RyanMeulenkamp/uselessbox/schematics/uselessbox.pdf

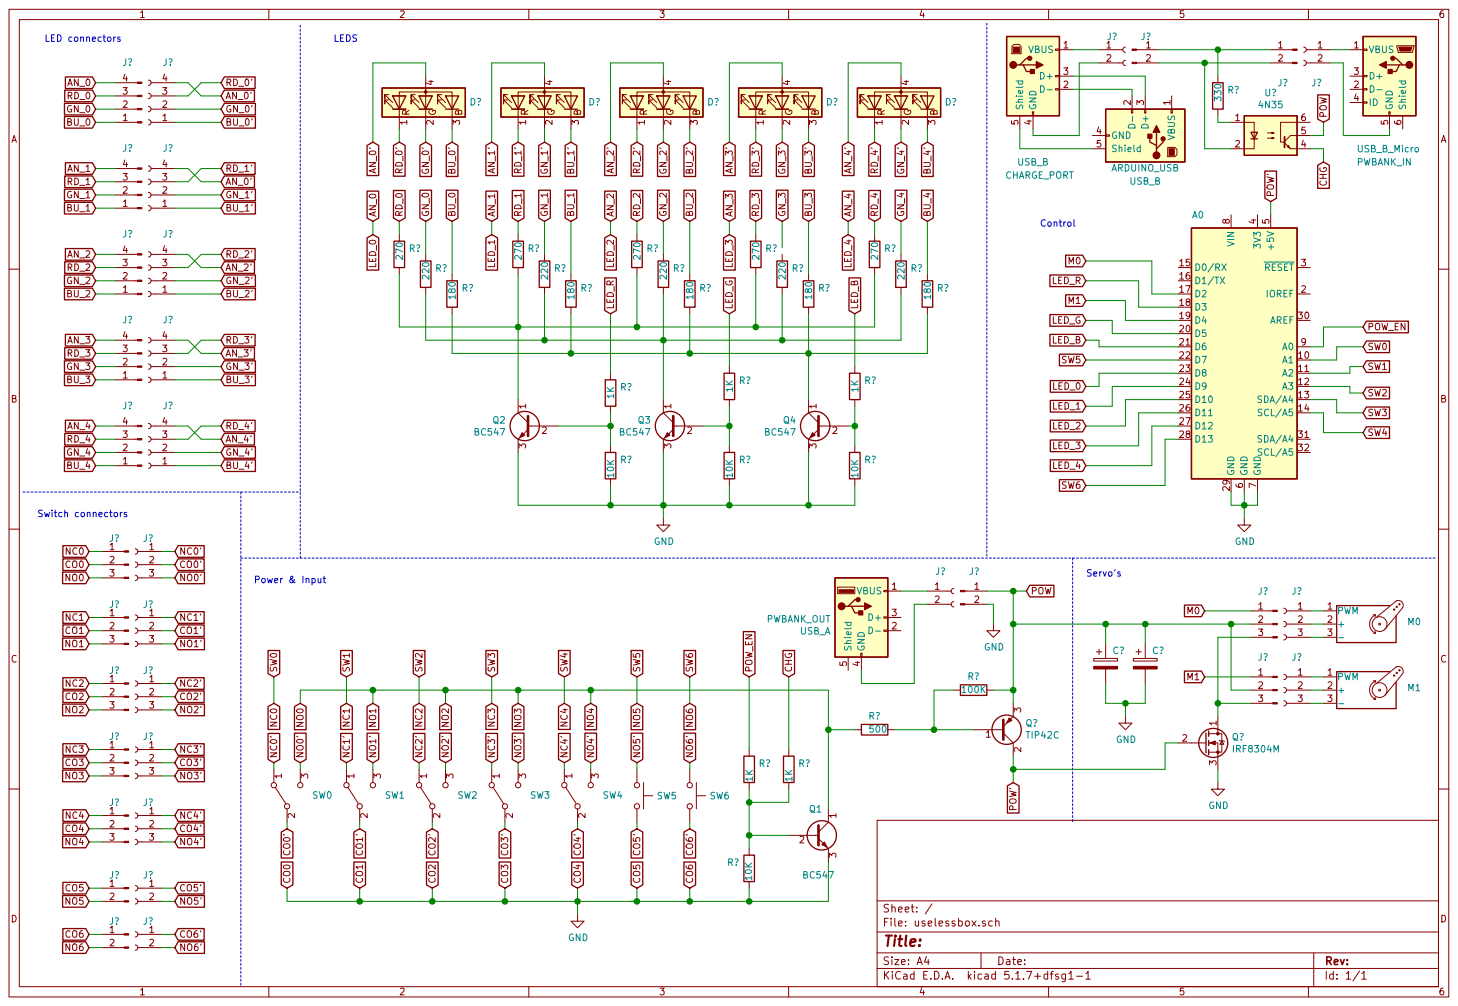
[picture p4: page 1]

Id: 1/1 Title: File: uselessbox.sch Sheet: / 1
