RyanMeulenkamp/uselessbox/schematics/uselessbox.sch

## KiCad design schematics/uselessbox.sch (2020-10-09)

Schematic: uselessbox.sch

Parts:
A0: Arduino_UNO_R3
ARDUINO_USB: USB_B
CHARGE_PORT: USB_B
M0, M1: Motor_Servo
PWBANK_IN: USB_B_Micro
PWBANK_OUT: USB_A
Q1, Q2, Q3, Q4: BC547; TO-92_Inline
SW0, SW1, SW2, SW3, SW4: SW_SPDT
SW5, SW6: SW_Push

Notes on the sheet:
LEDS
Control
Power & Input
Switch connectors
LED connectors
Servo's
