RyanMeulenkamp/uselessbox/(threads)

Thread 4 (2020-10-09):

Add calibration mode

RyanMeulenkamp, 2020-10-09:
Currently the box has three modes:

* Normal useless box mode
* Puzzle mode - guess the correct order
* Checkbox mode

It would be cool to add a calibration mode that could be used to modify the positions of the switches and possibly the colors of the LED's

Thread 5 (2020-10-09):

Add selftest mode

RyanMeulenkamp, 2020-10-09:
Other than the three modes it has already, add a selftest mode in which it loops all functionalities. That way we could determine if hardware is working correctly. There is something like this in the codebase but it is not converted to work with the box fully assembled. Also, it's not reachable using the buttons.

Thread 7 (2020-10-09):

Create PCB

RyanMeulenkamp, 2020-10-09:
The complete thing is now build using prototype board. I'm thinking of creating a custom PCB instead, now that the prototype is done.
