RyanMeulenkamp/uselessbox/code/include/pin_definitions.h

#ifndef PIN_DEFINITONS_H
#define PIN_DEFINITONS_H

#include <Arduino.h>

// Pin definitions
const int SWITCH[] = {A1, A2, A3, A4, A5};
const int POWER_ENABLE = A0;
const int LED[] = {8, 9, 10, 11, 12};
const int BUTTON[] = {7, 13};

const int LED_RD = 6;
const int LED_BU = 3;
const int LED_GN = 5;

#endif /* TEST_SEQUENCE_H */
