RyanMeulenkamp/uselessbox/(commit log)

2020-10-09 📜 Fill README.md (#8)
    The Readme needed to have something in there actually describing the
    project.
    Fixes: #1
2020-10-09 🔋 Add electronics design (#9)
    The schematics were made using KiCAD.
    Fixes #2
    [uselessbox.sch]
2020-10-09 👨‍💻 Add source code (#12)
    Fixes #3
    [box.cpp, box.hpp, buttons.cpp, buttons.hpp, calibration.h, leds.cpp, leds.hpp, main.cpp]
2020-10-09 👨‍💻 Add software design (#13)
